catdisk04/ME2400_project/README.md

# ME2400_project
2024 ME2400 project: Pitch perfect. PID control of pitch angle of propeller on the end of a lever
